JediJeremy/PulseEcho/modified_3.jpg

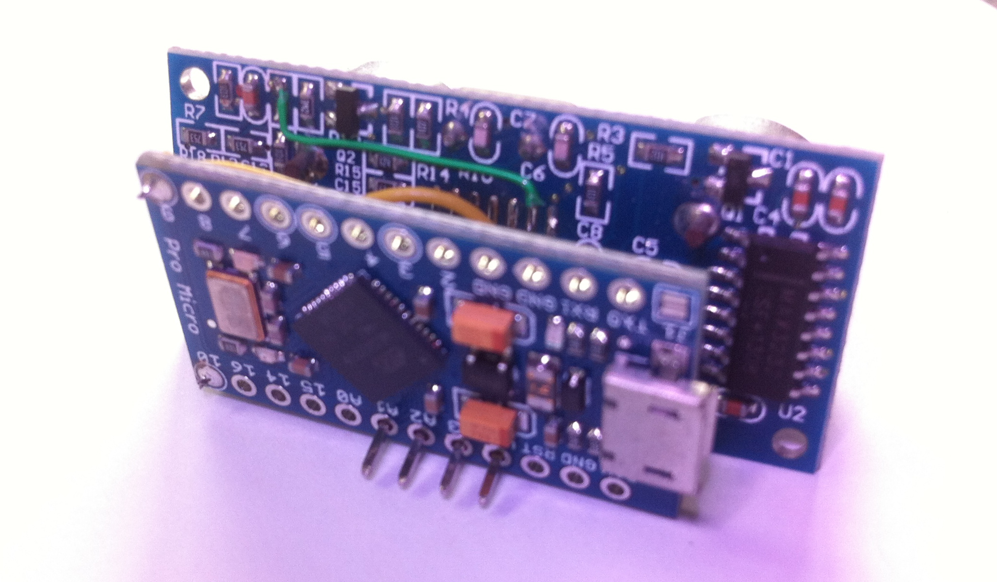
modified_3.jpg
