JediJeremy/PulseEcho/parts_2.jpg

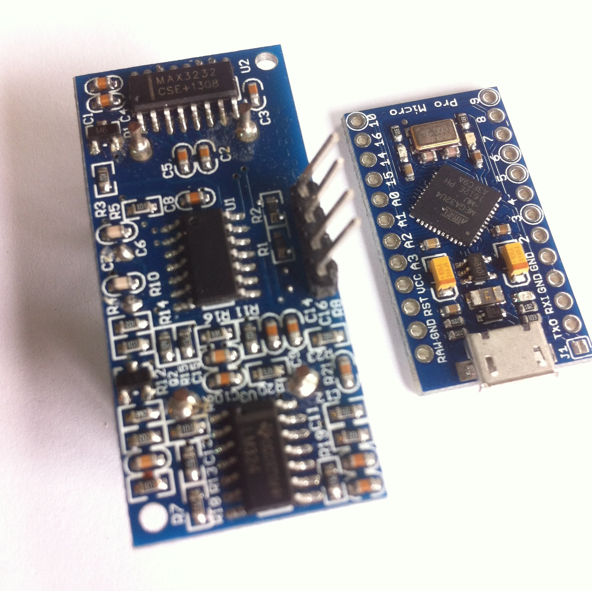
parts_2.jpg
